innocircuitslab/ESP32-S3-Thermal-Camera-MLX90640/ESP32-S3-Thermal-Camera-MLX90640/enclosure/V4_REAL_PRINT_FIX/07_assembly_closed_V4_REAL_PRINT_FIX.step

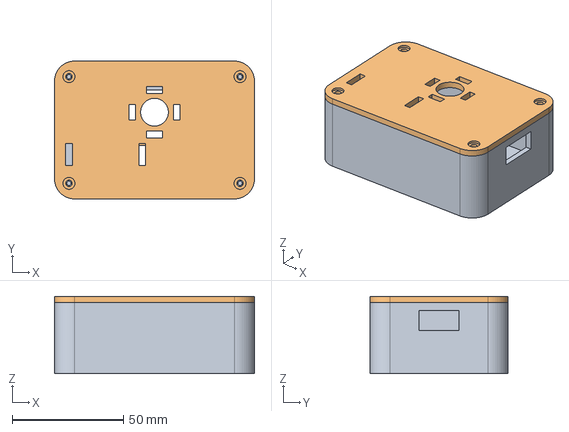
[picture p2: CAD file, 2026-10-20]
ESP32-S3-Thermal-Camera-MLX90640/enclosure/V4_REAL_PRINT_FIX/07_assembly_closed_V4_REAL_PRINT_FIX.step
90.0 x 62.0 x 34.8 mm
