innocircuitslab/ESP32-S3-Thermal-Camera-MLX90640/ESP32-S3-Thermal-Camera-MLX90640/enclosure/V4_REAL_PRINT_FIX/03_display_window_fit_test.step

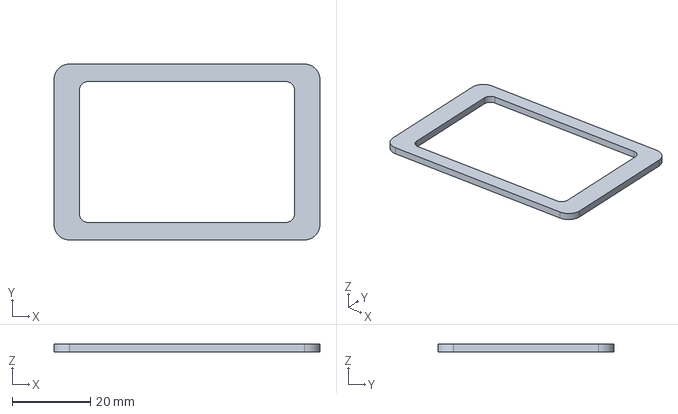
[picture p3: CAD file, 2026-10-20]
ESP32-S3-Thermal-Camera-MLX90640/enclosure/V4_REAL_PRINT_FIX/03_display_window_fit_test.step
68.0 x 45.0 x 2.00 mm
