innocircuitslab/ESP32-S3-Thermal-Camera-MLX90640/ESP32-S3-Thermal-Camera-MLX90640/enclosure/V4_REAL_PRINT_FIX/06_corner_cover_fit_test.step

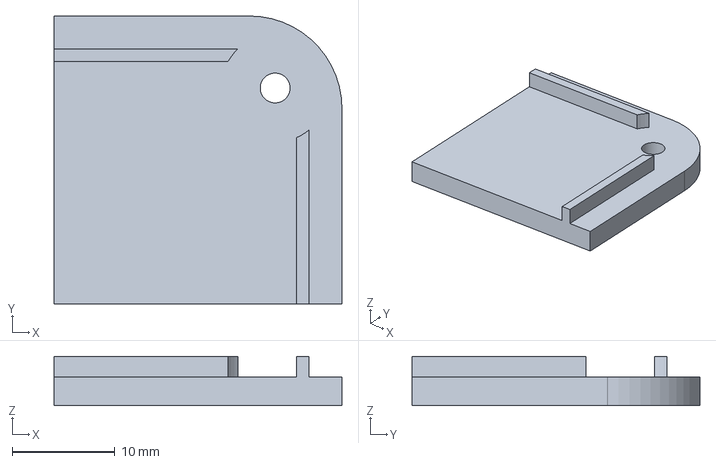
[picture p4: CAD file, 2026-10-20]
ESP32-S3-Thermal-Camera-MLX90640/enclosure/V4_REAL_PRINT_FIX/06_corner_cover_fit_test.step
28.0 x 28.0 x 4.80 mm
