innocircuitslab/ESP32-S3-Thermal-Camera-MLX90640/ESP32-S3-Thermal-Camera-MLX90640/enclosure/V4_REAL_PRINT_FIX/02_rear_cover_V4_REAL_PRINT_FIX.step

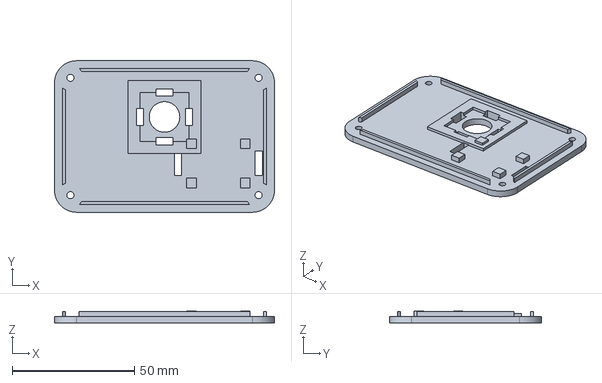
[picture p7: CAD file, 2026-10-20]
ESP32-S3-Thermal-Camera-MLX90640/enclosure/V4_REAL_PRINT_FIX/02_rear_cover_V4_REAL_PRINT_FIX.step
90.0 x 62.0 x 5.00 mm
