innocircuitslab/ESP32-S3-Thermal-Camera-MLX90640/(list of files, cad)

Other CAD files:
ESP32-S3-Thermal-Camera-MLX90640/enclosure/V4_REAL_PRINT_FIX/01_front_body_V4_REAL_PRINT_FIX.stl
ESP32-S3-Thermal-Camera-MLX90640/enclosure/V4_REAL_PRINT_FIX/02_rear_cover_V4_REAL_PRINT_FIX.stl
ESP32-S3-Thermal-Camera-MLX90640/enclosure/V4_REAL_PRINT_FIX/03_display_window_fit_test.stl
ESP32-S3-Thermal-Camera-MLX90640/enclosure/V4_REAL_PRINT_FIX/04_lens_hole_fit_test.stl
ESP32-S3-Thermal-Camera-MLX90640/enclosure/V4_REAL_PRINT_FIX/05_corner_body_fit_test.stl
ESP32-S3-Thermal-Camera-MLX90640/enclosure/V4_REAL_PRINT_FIX/06_corner_cover_fit_test.stl
